CarsonDecapod/Loom_AK4619/Loom_AK4619.kicad_pcb

## KiCad design Loom_AK4619.kicad_pcb (2025-01-11)

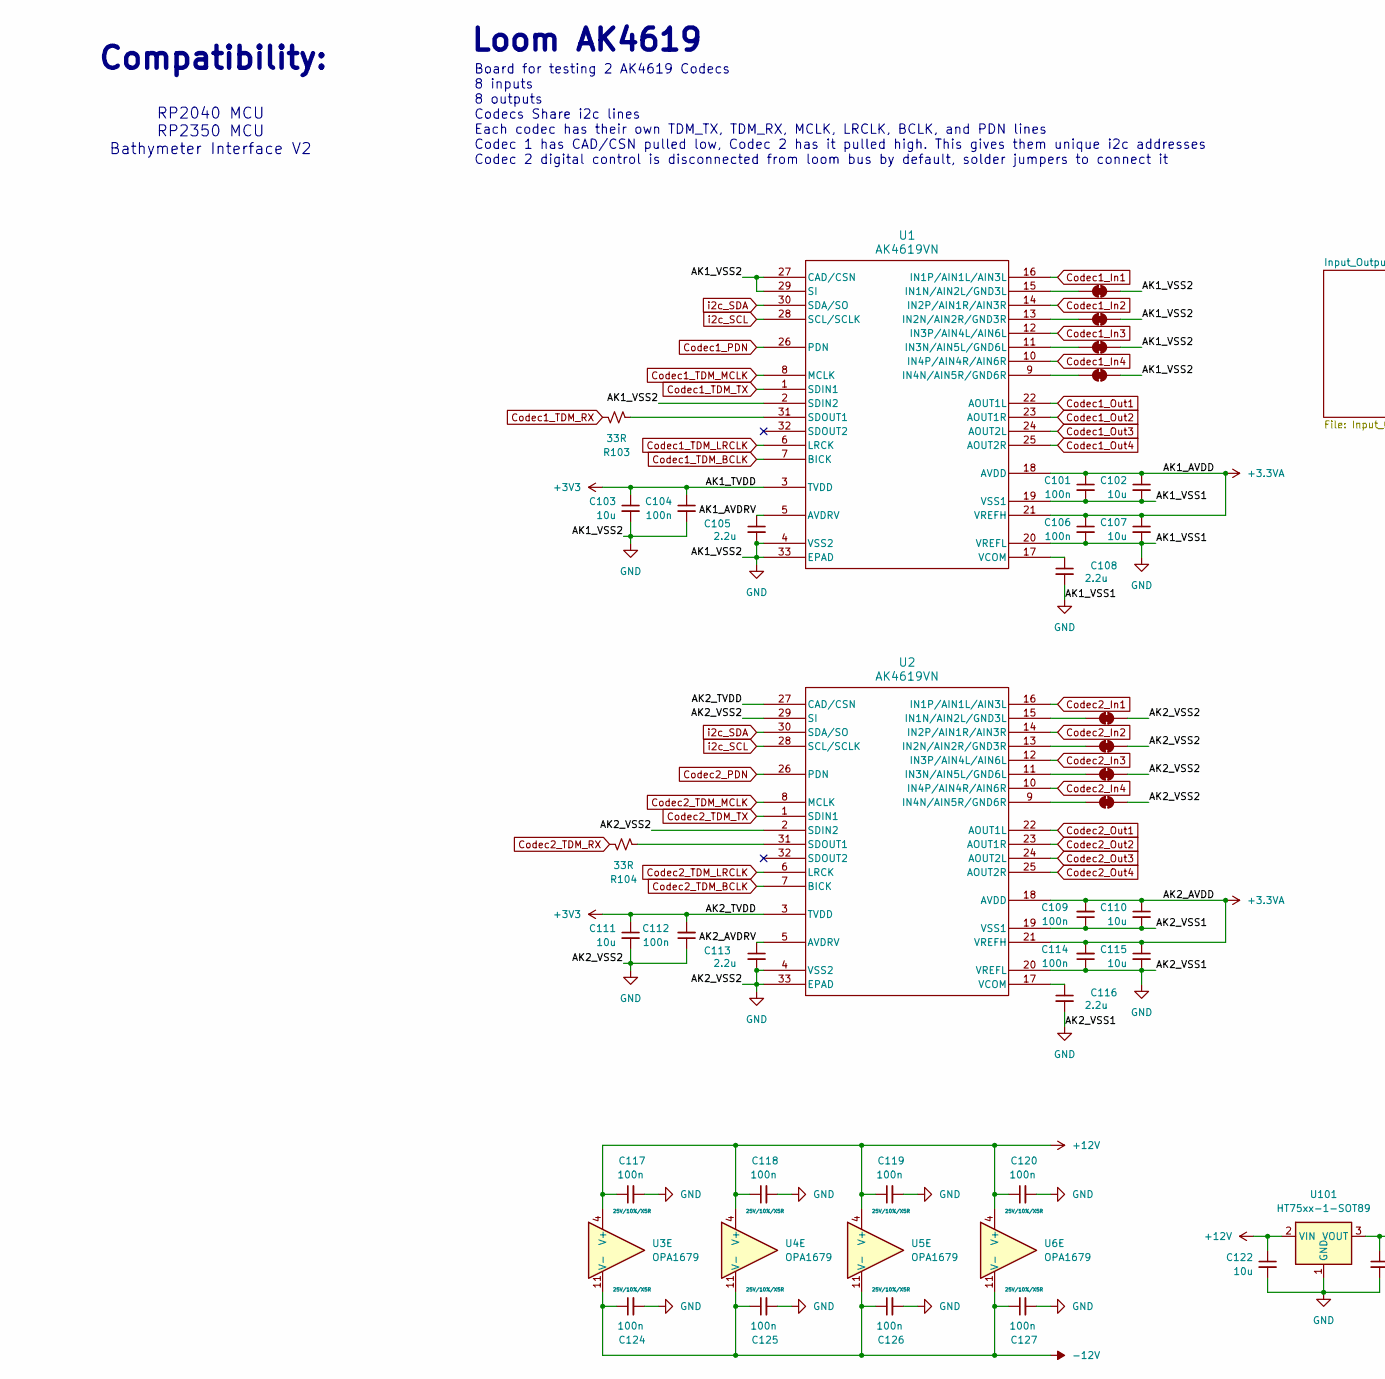
[picture p1: schematic Loom_AK4619.kicad_sch, part in row 1, column 1]

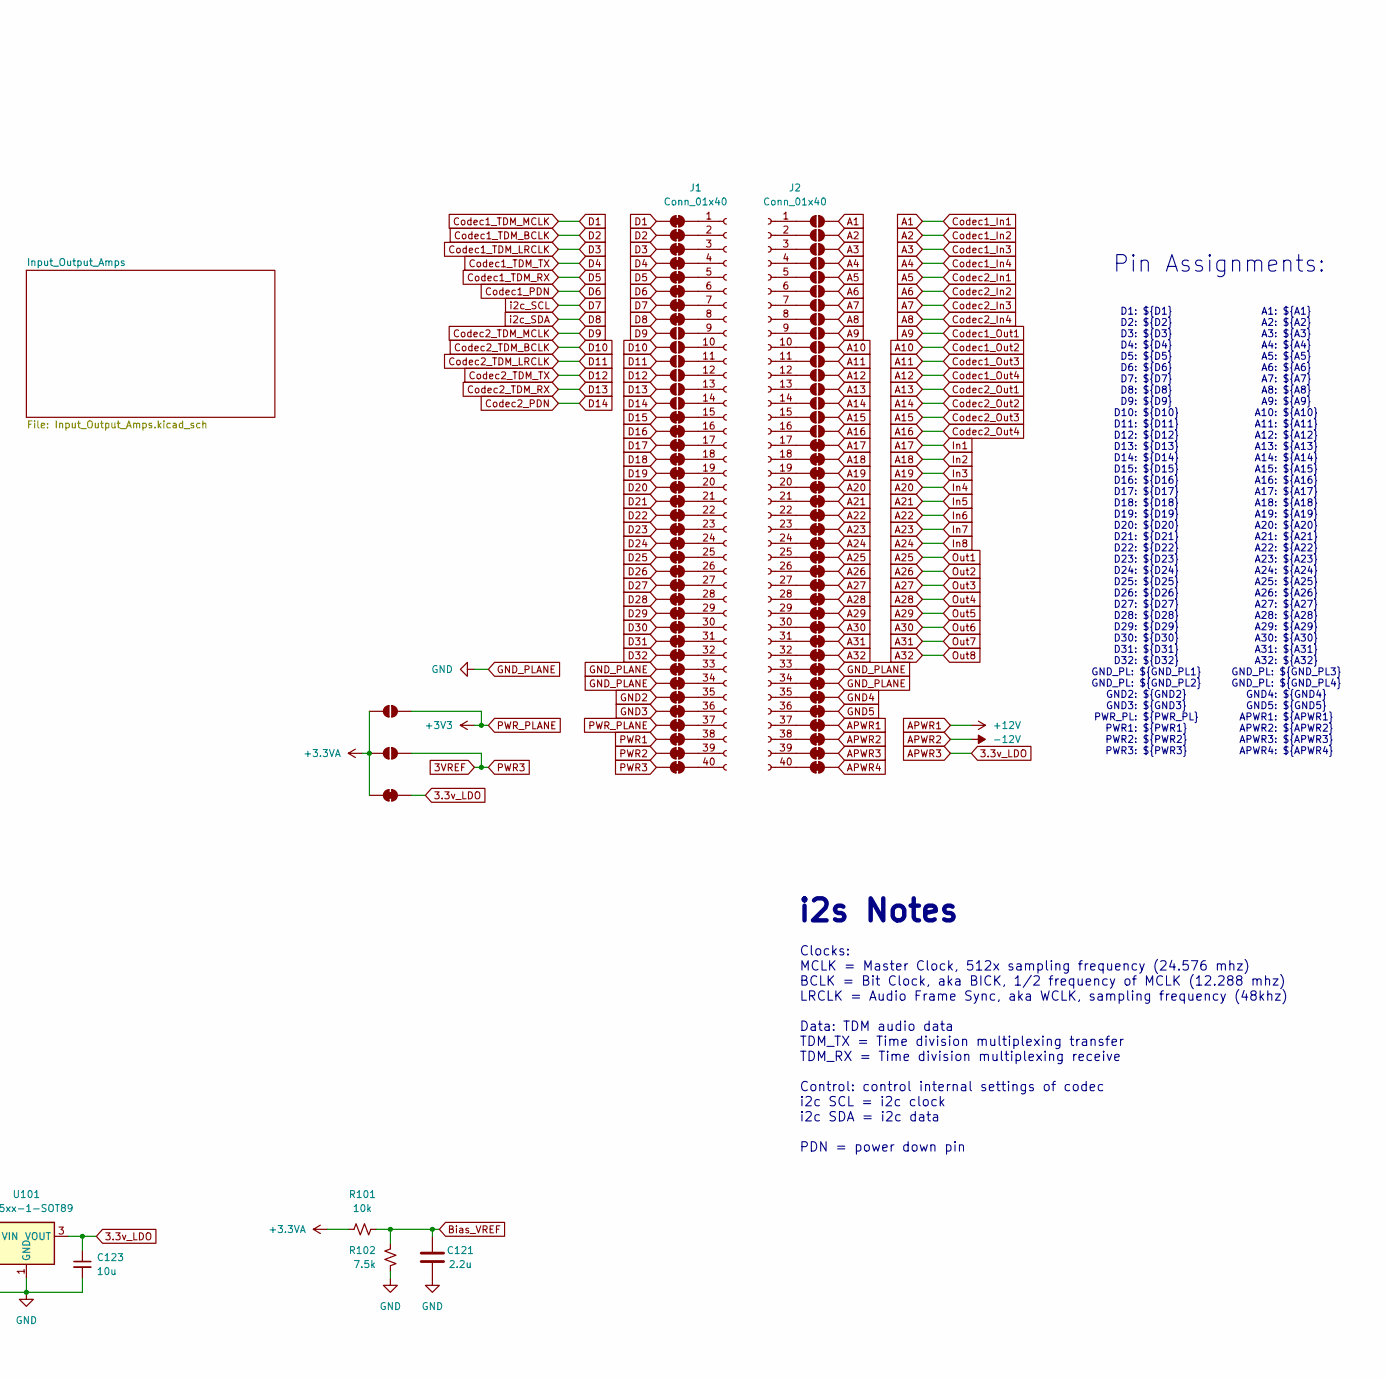
[picture p2: schematic Loom_AK4619.kicad_sch, part in row 1, column 2]

Parts:
C101, C104, C106: 100n; C_0603_HandSolder; Rating 25V/10%/C0G; LCSC C1591
C102, C103, C107, C110, C111, C115, C122, C123: 10u; C_0805_HandSolder; Rating 25V/10%/C0G; LCSC C15850
C105, C108, C113, C116: 2.2u; C_0805_HandSolder; Rating 25V/10%/C0G; LCSC C377773
C109, C112, C114, C117, C118, C119, C120, C124, C125, C126, C127: 100n; C_0603_HandSolder; Rating 25V/10%/X5R; DigiKey 1276-1000-2-ND
C121: 2.2u; C_0805_HandSolder; LCSC C377773
J1, J2: Conn_01x40; PinHeader_1x40_P2.54mm_Vertical
JP101, JP102, JP103, JP104, JP105, JP106, JP107, JP108, JP115, JP116, JP117, JP118, JP119, JP120, JP121, JP122, JP123, JP124, JP125, JP126, JP127, JP128, JP129, JP130, JP131, JP132, JP133, JP134, JP135, JP136, JP137, JP138, JP139, JP140, JP157, JP158, JP159, JP160, JP161, JP162, JP163, JP164, JP165, JP166, JP167, JP168, JP169, JP170, JP171, JP172, JP173, JP174, JP175, JP176, JP177, JP178, JP179, JP180, JP181, JP182, JP183, JP184, JP186, JP187, JP189, JP190, JP191: SolderJumper-2_P1.3mm_Bridged_RoundedPad1.0x1.5mm
JP109, JP110, JP111, JP112, JP113, JP114, JP141, JP142, JP143, JP144, JP145, JP146, JP147, JP148, JP149, JP150, JP151, JP152, JP153, JP154, JP155, JP156, JP185, JP188: SolderJumper_2_Open; SolderJumper-2_P1.3mm_Open_Pad1.0x1.5mm
R101: 10k; R_0603_HandSolder; Rating 100mW/1%/Thin
R102: 7.5k; R_0603_HandSolder; Rating 100mW/1%/Thin
R103, R104: 33R; R_0603_HandSolder; Rating 100mW/1%/Thin
U1, U2: AK4619VN; QFN-32-1EP_5x5mm_P0.5mm_EP3.7x3.7mm_ThermalVias; LCSC C3034747
U3, U4, U5, U6: OPA1679; TSSOP-14_4.4x5mm_P0.65mm; MPN OPA1679
U101: HT75xx-1-SOT89; SOT-89-3

Connections:
3.3v_LDO: C123.1, JP179.1 (A), JP190.1 (A), U101.3 (VOUT)
3VREF: JP140.2 (B), JP188.2 (B)
+3.3VA: C101.1, C102.1, C106.1, C107.1, C109.2, C110.1, C114.2, C115.1, JP185.1 (A), JP188.1 (A), JP190.2 (B), R101.1, U1.18 (AVDD), U1.21 (VREFH), U2.18 (AVDD), U2.21 (VREFH)
/AK1_AVDRV: C105.1, U1.5 (AVDRV)
/AK2_AVDRV: C113.1, U2.5 (AVDRV)
A1: JP141.2 (B), U1.16 (IN1P/AIN1L/AIN3L); also elsewhere on the board
A2: JP142.2 (B), U1.14 (IN2P/AIN1R/AIN3R); also elsewhere on the board
A3: JP143.2 (B), U1.12 (IN3P/AIN4L/AIN6L); also elsewhere on the board
A4: JP144.2 (B), U1.10 (IN4P/AIN4R/AIN6R); also elsewhere on the board
A5: JP145.2 (B), U2.16 (IN1P/AIN1L/AIN3L); also elsewhere on the board
A6: JP146.2 (B), U2.14 (IN2P/AIN1R/AIN3R); also elsewhere on the board
A7: JP147.2 (B), U2.12 (IN3P/AIN4L/AIN6L); also elsewhere on the board
A8: JP148.2 (B), U2.10 (IN4P/AIN4R/AIN6R); also elsewhere on the board
A9: JP149.2 (B), U1.22 (AOUT1L); also elsewhere on the board
A10: JP150.2 (B), U1.23 (AOUT1R); also elsewhere on the board
A11: JP151.2 (B), U1.24 (AOUT2L); also elsewhere on the board
A12: JP152.2 (B), U1.25 (AOUT2R); also elsewhere on the board
A13: JP153.2 (B), U2.22 (AOUT1L); also elsewhere on the board
A14: JP154.2 (B), U2.23 (AOUT1R); also elsewhere on the board
A15: JP155.2 (B), U2.24 (AOUT2L); also elsewhere on the board
A16: JP156.2 (B), U2.25 (AOUT2R); also elsewhere on the board
A17: JP157.1 (A); also elsewhere on the board
A18: JP158.1 (A); also elsewhere on the board
A19: JP159.1 (A); also elsewhere on the board
A20: JP160.1 (A); also elsewhere on the board
A21: JP161.1 (A); also elsewhere on the board
A22: JP162.1 (A); also elsewhere on the board
A23: JP163.1 (A); also elsewhere on the board
A24: JP164.1 (A); also elsewhere on the board
A25: JP165.1 (A); also elsewhere on the board
A26: JP166.1 (A); also elsewhere on the board
A27: JP167.1 (A); also elsewhere on the board
A28: JP168.1 (A); also elsewhere on the board
A29: JP169.1 (A); also elsewhere on the board
A30: JP170.1 (A); also elsewhere on the board
A31: JP171.1 (A); also elsewhere on the board
A32: JP172.1 (A); also elsewhere on the board
APWR1: C117.1, C118.1, C119.1, C120.1, C122.1, JP177.1 (A), U3.4 (V+), U4.4 (V+), U5.4 (V+), U6.4 (V+), U101.2 (VIN)
APWR2: C124.1, C125.1, C126.1, C127.1, JP178.1 (A), U3.11 (V-), U4.11 (V-), U5.11 (V-), U6.11 (V-)
APWR4: JP180.1 (A)
Bias_VREF: C121.2, R101.2, R102.2, U3.3 (+), U3.5 (+), U3.10 (+), U4.3 (+), U4.5 (+), U4.10 (+), U5.5 (+), U5.10 (+), U5.12 (+), U6.5 (+), U6.10 (+), U6.12 (+); also elsewhere on the board
Codec1_PDN: JP106.2 (B), U1.26 (PDN)
Codec1_TDM_BCLK: JP102.2 (B), U1.7 (BICK)
Codec1_TDM_LRCLK: JP103.2 (B), U1.6 (LRCK)
Codec1_TDM_MCLK: JP101.2 (B), U1.8 (MCLK)
Codec1_TDM_RX: JP105.2 (B), R103.1
Codec1_TDM_TX: JP104.2 (B), U1.1 (SDIN1)
Codec2_PDN: JP114.1 (A), U2.26 (PDN)
Codec2_TDM_BCLK: JP110.1 (A), U2.7 (BICK)
Codec2_TDM_LRCLK: JP111.1 (A), U2.6 (LRCK)
Codec2_TDM_MCLK: JP109.1 (A), U2.8 (MCLK)
Codec2_TDM_RX: JP113.1 (A), R104.1
Codec2_TDM_TX: JP112.1 (A), U2.1 (SDIN1)
D7: JP107.2 (B), U1.28 (SCL/SCLK), U2.28 (SCL/SCLK)
D8: JP108.2 (B), U1.30 (SDA/SO), U2.30 (SDA/SO)
D15: JP115.2 (B)
D16: JP116.2 (B)
D17: JP117.2 (B)
D18: JP118.2 (B)
D19: JP119.2 (B)
D20: JP120.2 (B)
D21: JP121.2 (B)
D22: JP122.2 (B)
D23: JP123.2 (B)
D24: JP124.2 (B)
D25: JP125.2 (B)
D26: JP126.2 (B)
D27: JP127.2 (B)
D28: JP128.2 (B)
D29: JP129.2 (B)
D30: JP130.2 (B)
D31: JP131.2 (B)
D32: JP132.2 (B)
GND2: JP135.2 (B)
GND3: JP136.2 (B)
GND4: JP175.1 (A)
GND5: JP176.1 (A)
GND_PLANE: C101.2, C102.2, C103.2, C104.2, C105.2, C106.2, C107.2, C108.2, C109.1, C110.2, C111.2, C112.1, C113.2, C114.1, C115.2, C116.2, C117.2, C118.2, C119.2, C120.2, C121.1, C122.2, C123.2, C124.2, C125.2, C126.2, C127.2, JP133.2 (B), JP134.2 (B), JP173.1 (A), JP174.1 (A), JP181.1 (A), JP182.1 (A), JP183.1 (A), JP184.1 (A), JP186.1 (A), JP187.1 (A), JP189.1 (A), JP191.1 (A), R102.1, U1.2 (SDIN2), U1.4 (VSS2), U1.19 (VSS1), U1.20 (VREFL), U1.27 (CAD/CSN), U1.29 (SI), U1.33 (EPAD), U2.2 (SDIN2), U2.4 (VSS2), U2.19 (VSS1), U2.20 (VREFL), U2.29 (SI), U2.33 (EPAD), U101.1 (GND)
unnamed 78: U3.1; also elsewhere on the board
unnamed 79: U3.7; also elsewhere on the board
unnamed 80: U3.8; also elsewhere on the board
unnamed 82: U4.1; also elsewhere on the board
unnamed 83: U4.7; also elsewhere on the board
unnamed 84: U4.8; also elsewhere on the board
unnamed 87: U5.7; also elsewhere on the board
unnamed 88: U5.8; also elsewhere on the board
unnamed 89: U5.14; also elsewhere on the board
unnamed 91: U6.7; also elsewhere on the board
unnamed 92: U6.8; also elsewhere on the board
unnamed 93: U6.14; also elsewhere on the board
unnamed: J1.1, JP101.1 (A)
unnamed: J1.2, JP102.1 (A)
unnamed: J1.3, JP103.1 (A)
unnamed: J1.4, JP104.1 (A)
unnamed: J1.5, JP105.1 (A)
unnamed: J1.6, JP106.1 (A)
unnamed: J1.7, JP107.1 (A)
unnamed: J1.8, JP108.1 (A)
unnamed: J1.9, JP109.2 (B)
unnamed: J1.10, JP110.2 (B)
unnamed: J1.11, JP111.2 (B)
unnamed: J1.12, JP112.2 (B)
unnamed: J1.13, JP113.2 (B)
unnamed: J1.14, JP114.2 (B)
unnamed: J1.15, JP115.1 (A)
unnamed: J1.16, JP116.1 (A)
unnamed: J1.17, JP117.1 (A)
unnamed: J1.18, JP118.1 (A)
unnamed: J1.19, JP119.1 (A)
unnamed: J1.20, JP120.1 (A)
unnamed: J1.21, JP121.1 (A)
unnamed: J1.22, JP122.1 (A)
unnamed: J1.23, JP123.1 (A)
unnamed: J1.24, JP124.1 (A)
unnamed: J1.25, JP125.1 (A)
unnamed: J1.26, JP126.1 (A)
unnamed: J1.27, JP127.1 (A)
unnamed: J1.28, JP128.1 (A)
unnamed: J1.29, JP129.1 (A)
unnamed: J1.30, JP130.1 (A)
unnamed: J1.31, JP131.1 (A)
unnamed: J1.32, JP132.1 (A)
unnamed: J1.33, JP133.1 (A)
unnamed: J1.34, JP134.1 (A)
unnamed: J1.35, JP135.1 (A)
unnamed: J1.36, JP136.1 (A)
unnamed: J1.37, JP137.1 (A)
unnamed: J1.38, JP138.1 (A)
unnamed: J1.39, JP139.1 (A)
unnamed: J1.40, JP140.1 (A)
unnamed: J2.1, JP141.1 (A)
unnamed: J2.2, JP142.1 (A)
unnamed: J2.3, JP143.1 (A)
unnamed: J2.4, JP144.1 (A)
unnamed: J2.5, JP145.1 (A)
unnamed: J2.6, JP146.1 (A)
unnamed: J2.7, JP147.1 (A)
unnamed: J2.8, JP148.1 (A)
unnamed: J2.9, JP149.1 (A)
unnamed: J2.10, JP150.1 (A)
unnamed: J2.11, JP151.1 (A)
unnamed: J2.12, JP152.1 (A)
unnamed: J2.13, JP153.1 (A)
unnamed: J2.14, JP154.1 (A)
unnamed: J2.15, JP155.1 (A)
unnamed: J2.16, JP156.1 (A)
unnamed: J2.17, JP157.2 (B)
unnamed: J2.18, JP158.2 (B)
unnamed: J2.19, JP159.2 (B)
unnamed: J2.20, JP160.2 (B)
unnamed: J2.21, JP161.2 (B)
unnamed: J2.22, JP162.2 (B)
unnamed: J2.23, JP163.2 (B)
unnamed: J2.24, JP164.2 (B)
unnamed: J2.25, JP165.2 (B)
unnamed: J2.26, JP166.2 (B)
unnamed: J2.27, JP167.2 (B)
unnamed: J2.28, JP168.2 (B)
unnamed: J2.29, JP169.2 (B)
unnamed: J2.30, JP170.2 (B)
unnamed: J2.31, JP171.2 (B)
unnamed: J2.32, JP172.2 (B)
unnamed: J2.33, JP173.2 (B)
unnamed: J2.34, JP174.2 (B)
unnamed: J2.35, JP175.2 (B)
unnamed: J2.36, JP176.2 (B)
unnamed: J2.37, JP177.2 (B)
unnamed: J2.38, JP178.2 (B)
unnamed: J2.39, JP179.2 (B)
unnamed: J2.40, JP180.2 (B)
unnamed: JP181.2 (B), U1.15 (IN1N/AIN2L/GND3L)
unnamed: JP182.2 (B), U1.13 (IN2N/AIN2R/GND3R)
unnamed: JP183.2 (B), U1.11 (IN3N/AIN5L/GND6L)
unnamed: JP184.2 (B), U1.9 (IN4N/AIN5R/GND6R)
unnamed: JP186.2 (B), U2.15 (IN1N/AIN2L/GND3L)
unnamed: JP187.2 (B), U2.13 (IN2N/AIN2R/GND3R)
unnamed: JP189.2 (B), U2.11 (IN3N/AIN5L/GND6L)
unnamed: JP191.2 (B), U2.9 (IN4N/AIN5R/GND6R)
unnamed: R103.2, U1.31 (SDOUT1)
unnamed: C108.1, U1.17 (VCOM)
unnamed: R104.2, U2.31 (SDOUT1)
unnamed: C116.1, U2.17 (VCOM)
unnamed 186: U3.2 (-); also elsewhere on the board
unnamed 187: U3.6 (-); also elsewhere on the board
unnamed 188: U3.9 (-); also elsewhere on the board
unnamed 190: U4.2 (-); also elsewhere on the board
unnamed 191: U4.6 (-); also elsewhere on the board
unnamed 192: U4.9 (-); also elsewhere on the board
unnamed 195: U5.6 (-); also elsewhere on the board
unnamed 196: U5.9 (-); also elsewhere on the board
unnamed 197: U5.13 (-); also elsewhere on the board
unnamed 199: U6.6 (-); also elsewhere on the board
unnamed 200: U6.9 (-); also elsewhere on the board
unnamed 201: U6.13 (-); also elsewhere on the board
PWR1: JP138.2 (B)
PWR2: JP139.2 (B)
PWR_PLANE: C103.1, C104.1, C111.1, C112.2, JP137.2 (B), JP185.2 (B), U1.3 (TVDD), U2.3 (TVDD), U2.27 (CAD/CSN)

Notes on the sheet:
Pin Assignments:
A1: ${A1} A2: ${A2} A3: ${A3} A4: ${A4} A5: ${A5} A6: ${A6} A7: ${A7} A8: ${A8} A9: ${A9} A10: ${A10} A11: ${A11} A12: ${A12} A13: ${A13} A14: ${A14} A15: ${A15} A16: ${A16} A17: ${A17} A18: ${A18} A19: ${A19} A20: ${A20} A21: ${A21} A22: ${A22} A23: ${A23} A24: ${A24} A25: ${A25} A26: ${A26} A27: 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
Clocks: MCLK = Master Clock, 512x sampling frequency (24.576 mhz) BCLK = Bit Clock, aka BICK, 1/2 frequency of MCLK (12.288 mhz) LRCLK = Audio Frame Sync, aka WCLK, sampling frequency (48khz) Data: TDM audio data TDM_TX = Time division multiplexing transfer TDM_RX = Time division multiplexing recei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
Loom AK4619
i2s Notes
Board for testing 2 AK4619 Codecs 8 inputs 8 outputs Codecs Share i2c lines Each codec has their own TDM_TX, TDM_RX, MCLK, LRCLK, BCLK, and PDN lines Codec 1 has CAD/CSN pulled low, Codec 2 has it pulled high. This gives them unique i2c addresses Codec 2 digital control is disconnected from loom bu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
D1: ${D1} D2: ${D2} D3: ${D3} D4: ${D4} D5: ${D5} D6: ${D6} D7: ${D7} D8: ${D8} D9: ${D9} D10: ${D10} D11: ${D11} D12: ${D12} D13: ${D13} D14: ${D14} D15: ${D15} D16: ${D16} D17: ${D17} D18: ${D18} D19: ${D19} D20: ${D20} D21: ${D21} D22: ${D22} D23: ${D23} D24: ${D24} D25: ${D25} D26: ${D26} D27: 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
Compatibility:
RP2040 MCU RP2350 MCU Bathymeter Interface V2

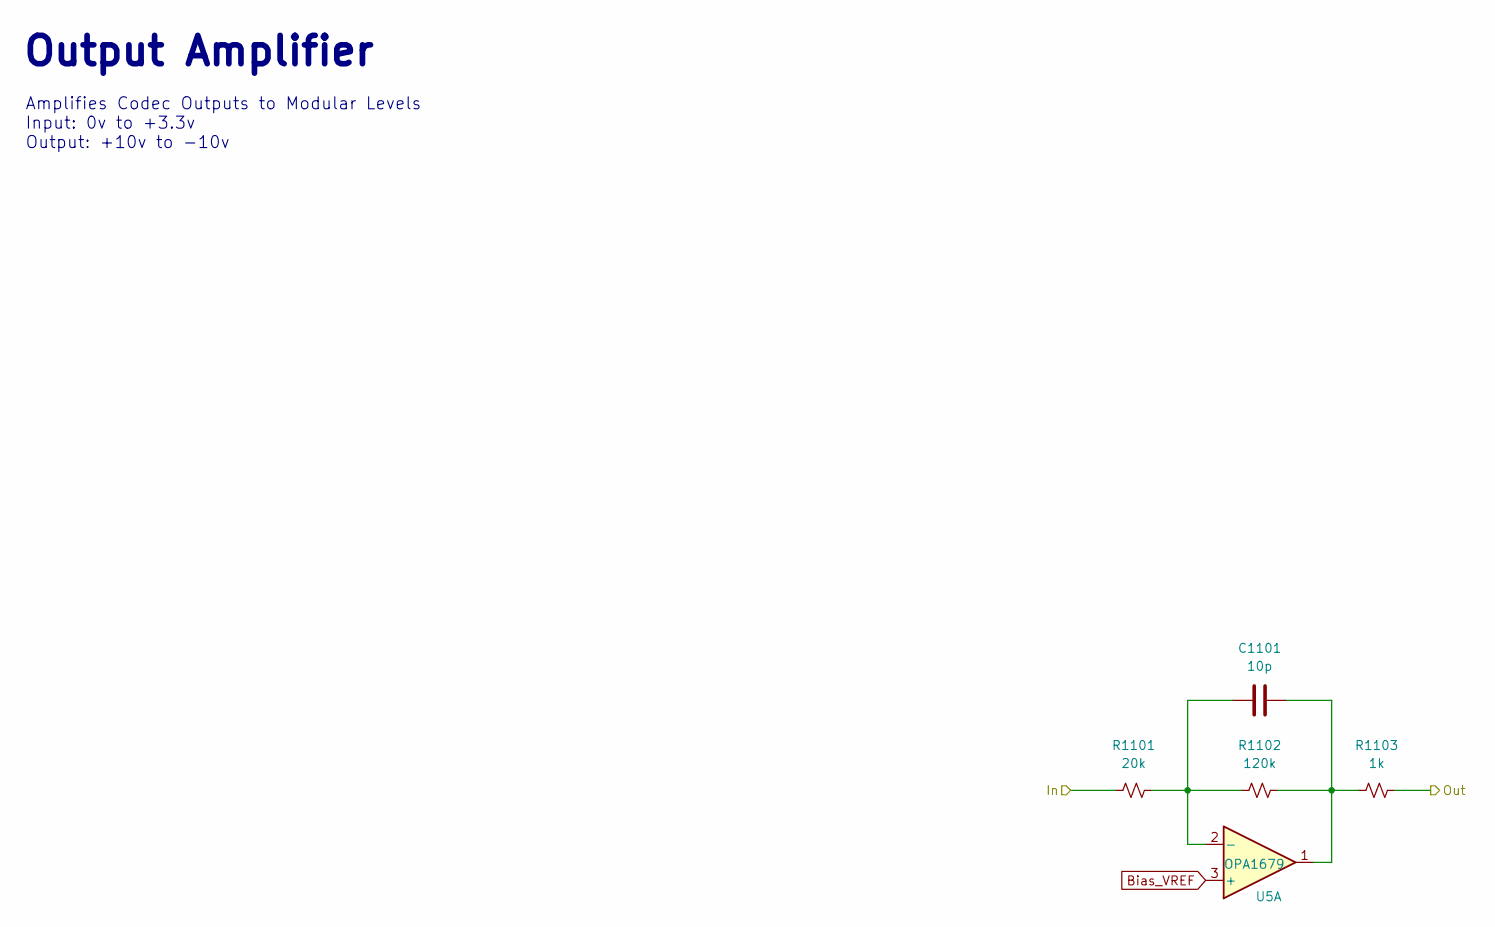
[picture p3: schematic Output_Amp.kicad_sch]

Parts:
C1101: 10p; C_0603_HandSolder; LCSC C1634
R1101: 20k; R_0603_HandSolder; Rating 100mW/1%/Thin
R1102: 120k; R_0603_HandSolder; Rating 100mW/1%/Thin
R1103: 1k; R_0603_HandSolder; Rating 100mW/1%/Thin
U5: OPA1679; TSSOP-14_4.4x5mm_P0.65mm; MPN OPA1679

Connections:
A9: R1101.1; also elsewhere on the board
A25: R1103.2; also elsewhere on the board
Bias_VREF: U5.3 (+), U5.5 (+), U5.10 (+), U5.12 (+); also elsewhere on the board
unnamed: C1101.1, R1102.2, R1103.1, U5.1
unnamed 87: U5.7; also elsewhere on the board
unnamed 88: U5.8; also elsewhere on the board
unnamed 89: U5.14; also elsewhere on the board
unnamed: C1101.2, R1101.2, R1102.1, U5.2 (-)
unnamed 195: U5.6 (-); also elsewhere on the board
unnamed 196: U5.9 (-); also elsewhere on the board
unnamed 197: U5.13 (-); also elsewhere on the board

Parts of its further copies:
C1201, C1301, C1401, C1501, C1601, C1701, C1801: 10p; C_0603_HandSolder; LCSC C1634
R1201, R1301, R1401, R1501, R1601, R1701, R1801: 20k; R_0603_HandSolder; Rating 100mW/1%/Thin
R1202, R1302, R1402, R1502, R1602, R1702, R1802: 120k; R_0603_HandSolder; Rating 100mW/1%/Thin
R1203, R1303, R1403, R1503, R1603, R1703, R1803: 1k; R_0603_HandSolder; Rating 100mW/1%/Thin

Connections of its further copies:
A10: R1201.1; also elsewhere on the board
A11: R1301.1; also elsewhere on the board
A12: R1401.1; also elsewhere on the board
A13: R1501.1; also elsewhere on the board
A14: R1601.1; also elsewhere on the board
A15: R1701.1; also elsewhere on the board
A16: R1801.1; also elsewhere on the board
A26: R1203.2; also elsewhere on the board
A27: R1303.2; also elsewhere on the board
A28: R1403.2; also elsewhere on the board
A29: R1503.2; also elsewhere on the board
A30: R1603.2; also elsewhere on the board
A31: R1703.2; also elsewhere on the board
A32: R1803.2; also elsewhere on the board
unnamed 87: C1201.1, R1202.2, R1203.1; also elsewhere on the board
unnamed 88: C1301.1, R1302.2, R1303.1; also elsewhere on the board
unnamed 89: C1401.1, R1402.2, R1403.1; also elsewhere on the board
unnamed 90: C1501.1, R1502.2, R1503.1; also elsewhere on the board
unnamed 91: C1601.1, R1602.2, R1603.1; also elsewhere on the board
unnamed 92: C1701.1, R1702.2, R1703.1; also elsewhere on the board
unnamed 93: C1801.1, R1802.2, R1803.1; also elsewhere on the board
unnamed 195: C1201.2, R1201.2, R1202.1; also elsewhere on the board
unnamed 196: C1301.2, R1301.2, R1302.1; also elsewhere on the board
unnamed 197: C1401.2, R1401.2, R1402.1; also elsewhere on the board
unnamed 198: C1501.2, R1501.2, R1502.1; also elsewhere on the board
unnamed 199: C1601.2, R1601.2, R1602.1; also elsewhere on the board
unnamed 200: C1701.2, R1701.2, R1702.1; also elsewhere on the board
unnamed 201: C1801.2, R1801.2, R1802.1; also elsewhere on the board

Notes on the sheet:
Amplifies Codec Outputs to Modular Levels Input: 0v to +3.3v Output: +10v to -10v
Output Amplifier

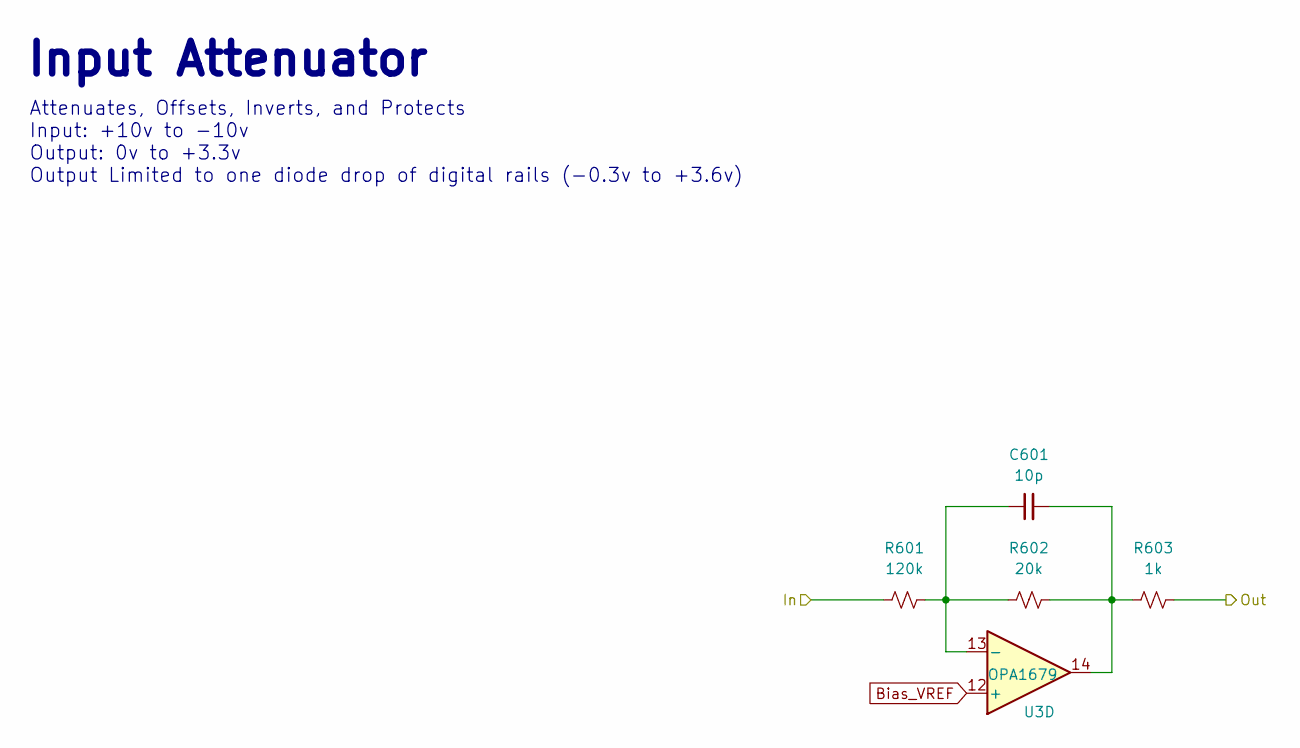
[picture p4: schematic Input_Attenuator.kicad_sch]

Parts:
C601: 10p; C_0603_HandSolder; Rating 25V/10%/C0G; LCSC C1634
R601: 120k; R_0603_HandSolder; Rating 100mW/1%/Thin
R602: 20k; R_0603_HandSolder; Rating 100mW/1%/Thin
R603: 1k; R_0603_HandSolder; Rating 100mW/1%/Thin
U3: OPA1679; TSSOP-14_4.4x5mm_P0.65mm; MPN OPA1679

Connections:
A4: R603.2; also elsewhere on the board
A20: R601.1; also elsewhere on the board
Bias_VREF: U3.3 (+), U3.5 (+), U3.10 (+), U3.12 (+); also elsewhere on the board
unnamed 78: U3.1; also elsewhere on the board
unnamed 79: U3.7; also elsewhere on the board
unnamed 80: U3.8; also elsewhere on the board
unnamed: C601.2, R602.2, R603.1, U3.14
unnamed 186: U3.2 (-); also elsewhere on the board
unnamed 187: U3.6 (-); also elsewhere on the board
unnamed 188: U3.9 (-); also elsewhere on the board
unnamed: C601.1, R601.2, R602.1, U3.13 (-)

Parts of its further copies:
C301, C401, C501, C701, C801, C901, C1001: 10p; C_0603_HandSolder; Rating 25V/10%/C0G; LCSC C1634
R301, R401, R501, R701, R801, R901, R1001: 120k; R_0603_HandSolder; Rating 100mW/1%/Thin
R302, R402, R502, R702, R802, R902, R1002: 20k; R_0603_HandSolder; Rating 100mW/1%/Thin
R303, R403, R503, R703, R803, R903, R1003: 1k; R_0603_HandSolder; Rating 100mW/1%/Thin

Connections of its further copies:
A1: R303.2; also elsewhere on the board
A2: R403.2; also elsewhere on the board
A3: R503.2; also elsewhere on the board
A5: R703.2; also elsewhere on the board
A6: R803.2; also elsewhere on the board
A7: R903.2; also elsewhere on the board
A8: R1003.2; also elsewhere on the board
A17: R301.1; also elsewhere on the board
A18: R401.1; also elsewhere on the board
A19: R501.1; also elsewhere on the board
A21: R701.1; also elsewhere on the board
A22: R801.1; also elsewhere on the board
A23: R901.1; also elsewhere on the board
A24: R1001.1; also elsewhere on the board
unnamed 78: C301.2, R302.2, R303.1; also elsewhere on the board
unnamed 79: C401.2, R402.2, R403.1; also elsewhere on the board
unnamed 80: C501.2, R502.2, R503.1; also elsewhere on the board
unnamed 82: C701.2, R702.2, R703.1; also elsewhere on the board
unnamed 83: C801.2, R802.2, R803.1; also elsewhere on the board
unnamed 84: C901.2, R902.2, R903.1; also elsewhere on the board
unnamed 85: C1001.2, R1002.2, R1003.1; also elsewhere on the board
unnamed 186: C301.1, R301.2, R302.1; also elsewhere on the board
unnamed 187: C401.1, R401.2, R402.1; also elsewhere on the board
unnamed 188: C501.1, R501.2, R502.1; also elsewhere on the board
unnamed 190: C701.1, R701.2, R702.1; also elsewhere on the board
unnamed 191: C801.1, R801.2, R802.1; also elsewhere on the board
unnamed 192: C901.1, R901.2, R902.1; also elsewhere on the board
unnamed 193: C1001.1, R1001.2, R1002.1; also elsewhere on the board

Notes on the sheet:
Attenuates, Offsets, Inverts, and Protects Input: +10v to -10v Output: 0v to +3.3v Output Limited to one diode drop of digital rails (-0.3v to +3.6v)
Input Attenuator

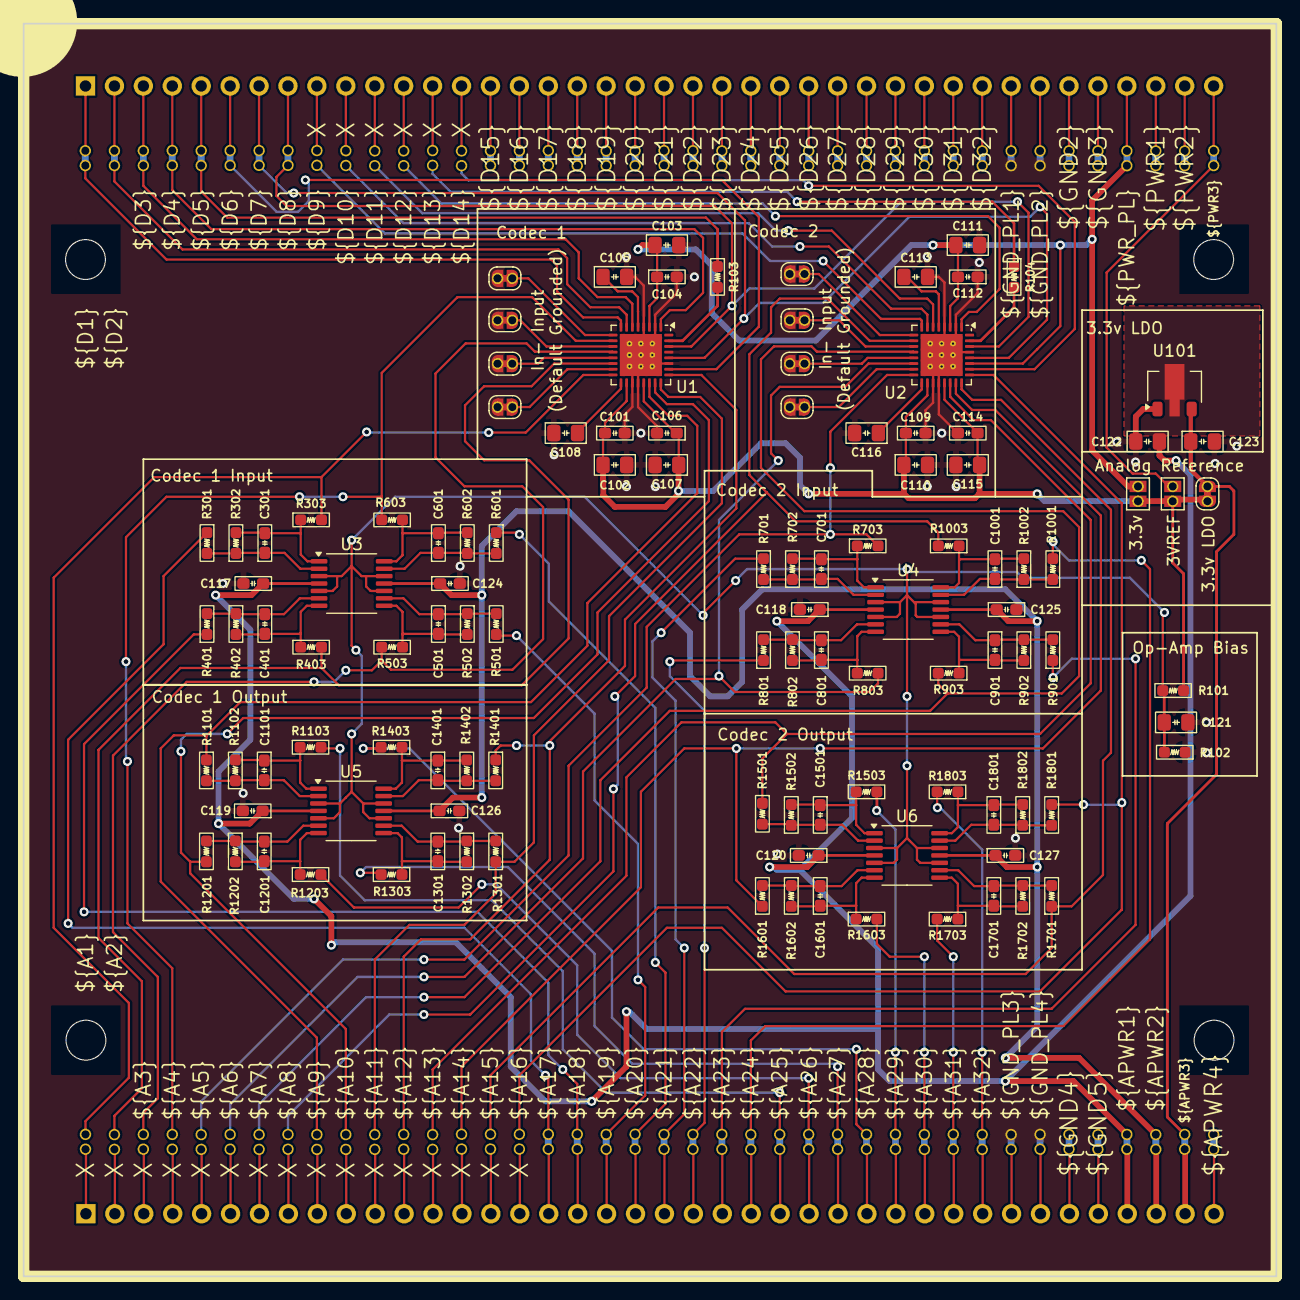
[picture p5: board Loom_AK4619.kicad_pcb from above]

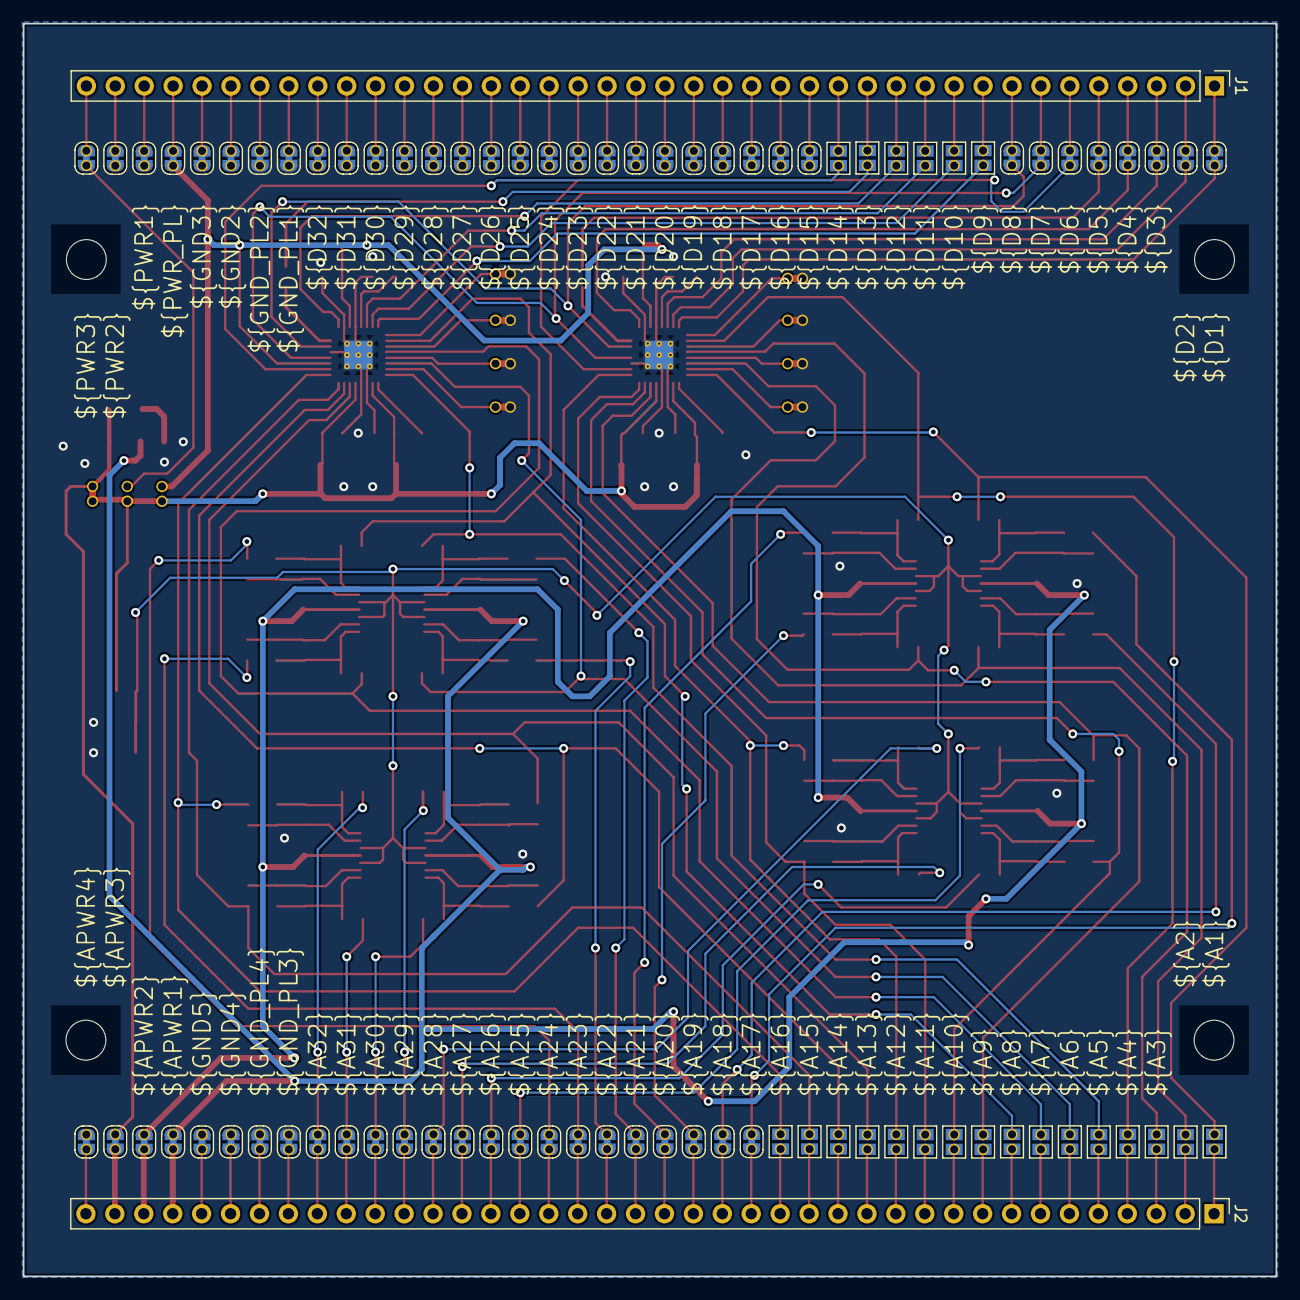
[picture p6: board Loom_AK4619.kicad_pcb from below]

Board: 2 copper layers, 110.0 x 110.0 mm, 195 parts (82 on the bottom side), 180 nets.
