CarsonDecapod/Loom_AK4619/(commit log)

2025-01-09 Slight routing updates
    [Loom_AK4619.kicad_pcb]
2025-01-11 Added 33R resistors to SDOUT
    Added 33R resistors to SDOUT to decrease slew rate slightly to reduce radiated emissions.
    [Input_Attenuator.kicad_sch, Loom_AK4619.kicad_pcb, Loom_AK4619.kicad_sch]
2025-02-09 Version 1 ready to order
    [Input_Attenuator.kicad_sch, Loom_AK4619.kicad_sch, Output_Amp.kicad_sch, bom.csv, designators.csv, positions.csv]
